HelenTsvetkova/KMM-2021/Манипулятор/Манипулятор_Обзор+ТЗ+расчеты двигателей.docx

Выбор конструкции манипулятора

# 1. Анализ технического задания

Целью работы является разработка манипулятора, являющегося составной частью подвижного робота, участвующего в соревновании «Кубок РТК».

Исходя из анализа регламента турнира [ССЫЛКА НА ИНТЕРНЕТ-РЕСУРС], разрабатываемый манипулятор должен соответствовать следующим требованиям:
Масса манипулятора: не более 2 кг;

Нагрузка на выходном звене: до 0,5 кг;

Крутящий момент на выходном звене: до 1 Н∙м ;

Для обеспечения конкурентоспособности разрабатываемого робота, произведен анализ возможных испытаний, задействующих манипулятор и проводимых на «Кубке РТК». Суть данных испытаний и их стоимость в баллах представлены в таблице 1.

Таблица 1 – Испытания, проводимые на Кубке РТК

Испытание | Описание | Возможные баллы
Траншея | Фанерная площадка с двумя продолговатыми прямоугольными траншеями глубиной 40 мм. Длина траншеи – 670 мм, ширина – 140 мм. Одна траншея заполнена теннисными мячами (65 мм в диаметре), вторая пустая. Задачи: - преодолеть испытание; - Доставить мяч из одной траншеи в другую. За каждый доставленный мяч начисляются баллы. | 4 + (5+3)x, где x – количество захваченных и доставленных в другую траншею мячей.

Продолжение таблицы 1

Дверь | Дверь открывающаяся в обе стороны на 90^(°) с ручкой типа штанга. Габаритные размеры двери – 480x480x8 мм. Для открытия необходимо усилие 200 г (2 Ньютона). Высота ручки над полом – 220 мм, толщина 8 мм, длина 110 мм. Задача: - Открыть дверь на себя или от себя (во втором случае необходимо привести дверь в положение "открыто" под углом 90^(°) . | 6 баллов – если открыть дверь на себя, 1 балл – если от себя.
Вентили | На стене закреплена конструкция из сантехнических труб с вентилями различного типа и размера: рычаг (размер ручки – 90x15x5 мм, ход - 90^(°) ), бабочка средняя (размер ручки – 50x15x5 мм, ход 70^(°) ), бабочка малая (размер ручки – 25х7х15 мм, ход - 90^(°) ), задвижка клиновая (размер ручки – 50х15х5 мм, ход – 3,5 полных оборота). Момент, необходимый для поворота вентилей: - бабочка маленькая и клиновая задвижка – 0,3 Нм; - рычаг – 0,5 Нм; - Бабочка средняя – 1 Нм. Задачи: - Повернуть вентиль до перекрытия риски, обозначенной маркером на вентиле. | За поворот рычага 10 баллов. За поворот клиновых задвижек – 11 баллов. За поворот малых и средних бабочек – по 12 баллов за каждую.

Продолжение таблицы 1

Кнопка | Обыкновенный бытовой выключатель для лампочки. При нажатии загорается светодиодная лента на участке "Туман". Кнопка расположена на высоте не более 70 мм от пола. Задача: - Нажать кнопку любым способом. | 3 балла

Маяки

Маяк представляет собой алюминиевый цилиндр диаметром 67 мм. Маяки имеют один из следующих цветов: красный, синий, зеленый, желтый, фиолетовый.

На линии для автономного прохождения также могут располагаться белые маяки. Робот при этом должен находиться на расстоянии более 30 см от маяка.

Башенка – постамент, представляющий собой миниатюрную копию специального испытания "Башня", с габаритными размерами 160 мм высотой и диаметром 90 мм. На него устанавливают стандартный маяк.

Задачи:

-Цветные маяки. Захват и подъем маяка, доставка любым способом его в соответствующую по цвету зону.

- Белые маяки. Захват и подъем маяка на перекрестке черных линий и доставка на другой перекресток.

- Башенка. Баллы за захват плюсуются с баллами за захват с башенки.

В зависимости от сложности испытания можно получить от 0 до 83 баллов.

Продолжение таблицы 1

Обломки | Предметы разного веса, размера, формы, текстуры. Материалы: пластик, дерево, резина, поролон. Габариты обломков колеблются в пределах от 160 до 35 мм, вес до 100 г. Задача: - Собрать предметы в корзинку (высота корзинки- 90 мм). За захват и доставку каждого предмета баллы начисляют отдельно. | Захват обломка – 4 балла, доставка – 3 балла.

Трубы

Конструкция из пластиковых труб, подвешенная на стене ячейки. Каждая труба оканчивается шестиугольной крышкой со стороной 40 мм. Длина подвижных трубок 60 мм.

Задача:

- Извлечь. В трубу вложена трубка меньшего диаметра. Робот должен захватить и полностью извлечь трубку

- Повернуть. В трубу вложена трубка меньшего диаметра. Робот должен повернуть трубку вокруг своей оси, на 180/360 градусов, не вытаскивая из основной трубы. Одну трубку можно повернуть не более, чем на один полный оборот ( 360^(°) ).

- Исследовать. Внутри трубы, на донышке написана буква/цифра. Оператор и судья должны четко разглядеть символ на дне трубы.

5 баллов за извлечение меньшей трубки из большей. 5 баллов за исследование того, что находится внутри большой трубки. 9 и 12 баллов можно получить за поворот меньшей трубки в большей на 180^(°) и 360^(°) соответственно.

Продолжение таблицы 1

Мишень | Концентрические круги, распечатанные на бумаге, и закрепленные на стенке полигона. Три мишени закреплены на разном уровне. Мишень состоит из 5 кругов разного диаметра. Диаметр мишени – около 15 см.

# 2. Обзор существующих решений

С целью определения наилучшей конструкции манипулятора для получения максимального количества баллов за испытания, решено провести обзор существующих конструкций манипуляторов и выбор самой подходящей из них. Объектами исследования стали манипуляторы роботов, участвовавшие в Кубке РТК в 2018–2021 годах.

Трудность данной задачи заключается в невозможности сопоставления фотографий роботов, принимающих участие в соревнованиях, с полученными ими результатами за каждое испытание. Вследствие этого принято решение проанализировать все имеющиеся фотографии на сайте Кубка РТК, разделив роботов на группы по количеству степеней подвижности манипулятора. Далее для каждой группы определены лучшие представители, и посчитано, какое количество баллов способен набрать каждый из них.

В результате проведенного анализа выявлено, что манипуляторы роботов-участников Кубка РТК делятся на следующие группы:

- с одной позиционирующей степенью подвижности (ПСП);
- с одной позиционирующей и одной ориентирующей степенью подвижности (ОСП);
- с двумя ПСП;
- с двумя ПСП и одной ОСП;
- с тремя ПСП;
- с тремя ПСП и одной ОСП;
- с тремя ПСП и двумя ОСП.

Лучшие представители данных групп представлены на рисунках 1–7.

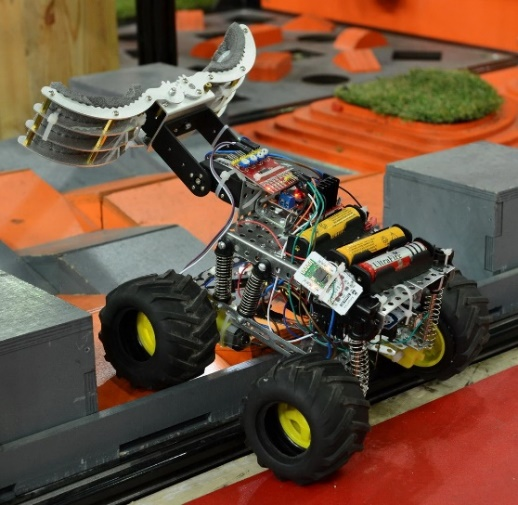
[picture p1: figure]

Рисунок 1 – Робот с манипулятором с одной ПСП

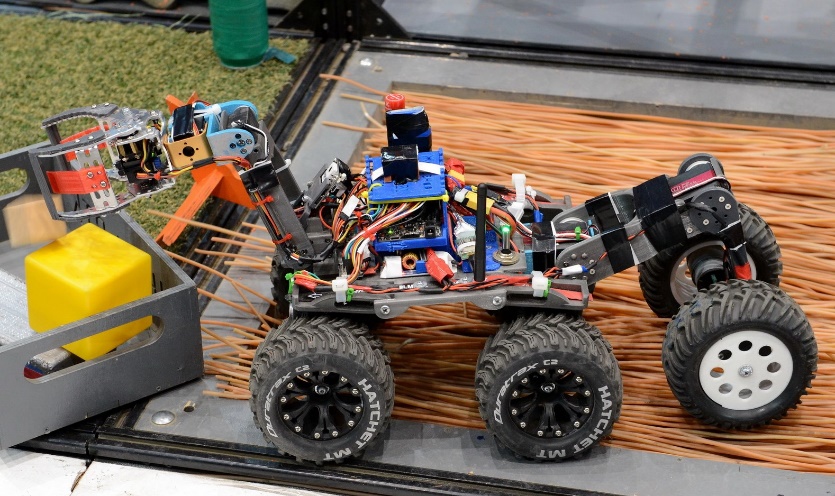
[picture p2: figure]

Рисунок 2 – Робот с манипулятором с двумя ПСП

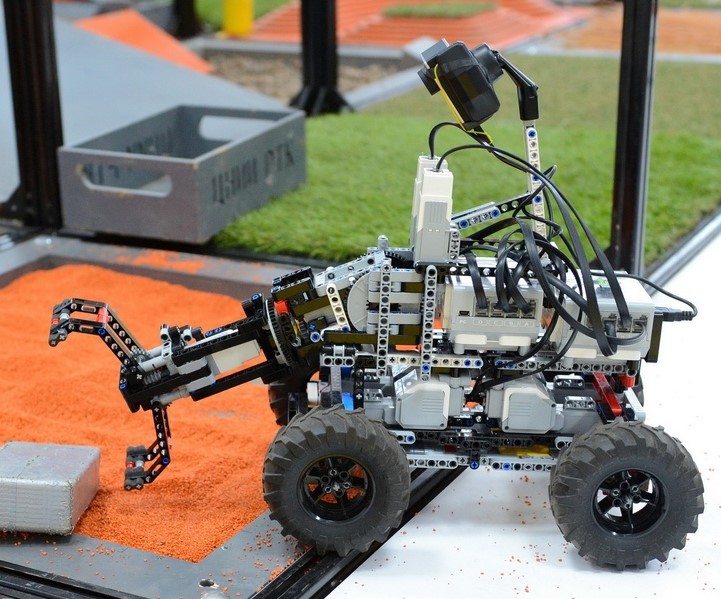
[picture p3: figure]

Рисунок 3 – Робот с манипулятором с одной ПСП и одной ОСП

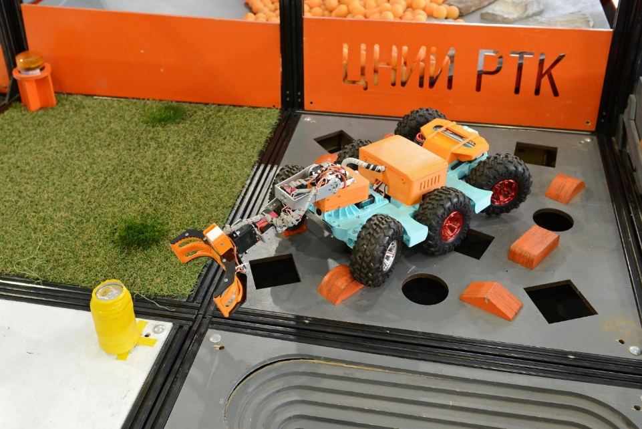
[picture p4: figure]

Рисунок 4 – Робот с манипулятором с тремя ПСП

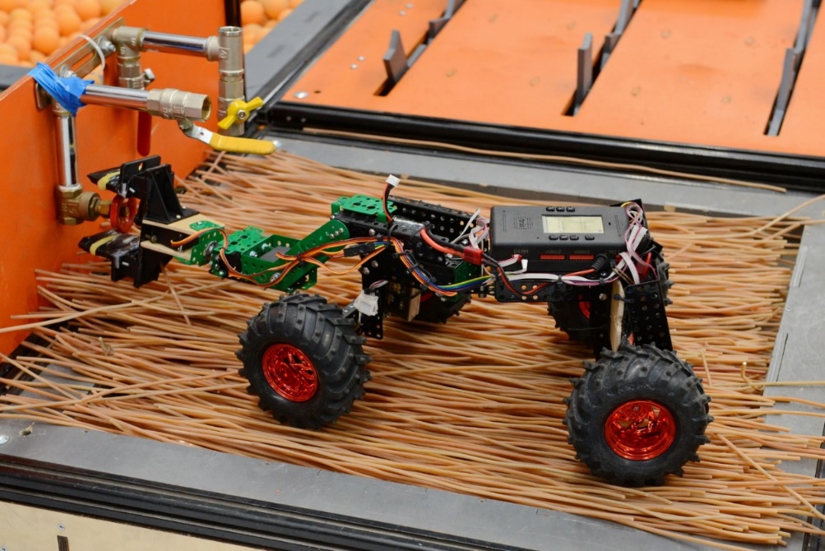
[picture p5: figure]

Рисунок 5 – Робот с манипулятором с двумя ПСП и одной ОСП

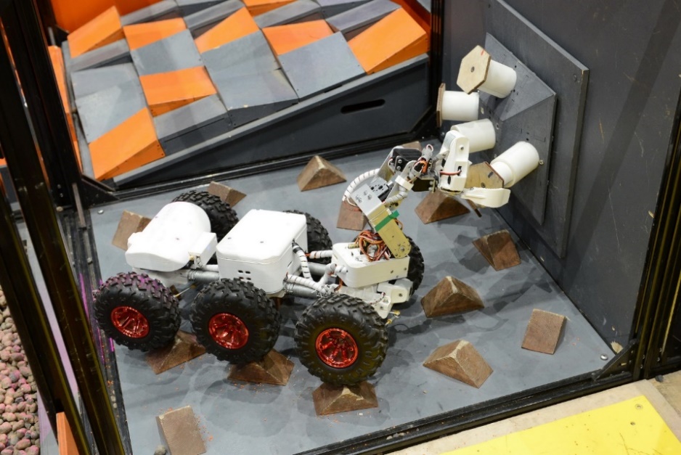
[picture p6: figure]

Рисунок 6 – Робот с манипулятором с четырьмя ПСП

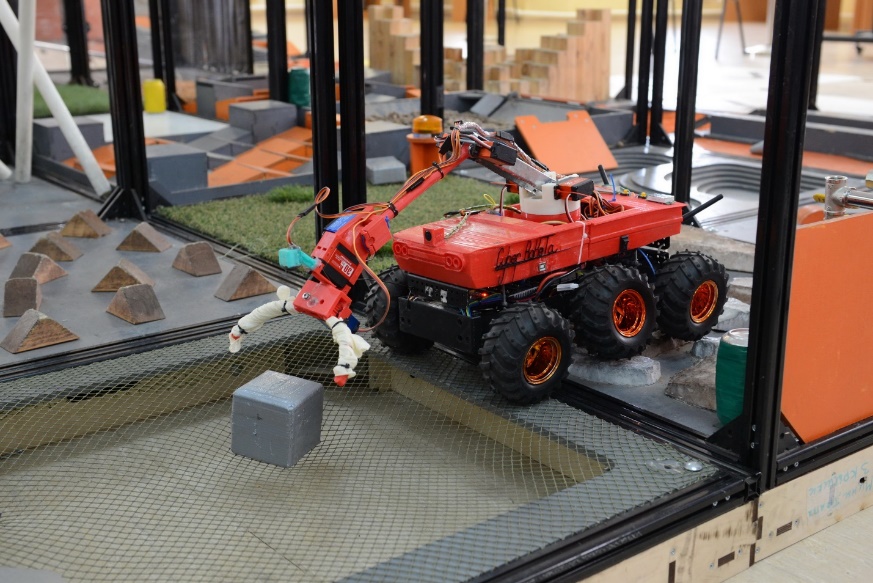
[picture p7: figure]

Рисунок 7 – Робот с манипулятором с тремя ПСП и одной ОСП

Произведен анализ успешности прохождений испытаний каждым из роботов (рис. 1–7). Результаты анализа представлены в таблице 2.
Таблица 2 – Оценочная таблица успешности прохождений испытаний роботами различных категорий

Испытание | 1 ПСП | 2 ПСП | 1 ПСП, 1 ОСП | 3 ПСП | 2 ПСП, 1 ОСП | 4 ПСП | 3 ПСП, 2 ОСП
Траншея | 8 | 8 | 8 | 8 | 8 | 8 | 8
Дверь | 6 | 6 | 6 | 6 | 6 | 6 | 6
Вентили | 0 | 0 | 45 | 0 | 45 | 45 | 45
Кнопка | 3 | 3 | 3 | 3 | 3 | 3 | 3
Маяки | 73 | 83 | 73 | 83 | 83 | 83 | 83
Обломки | 7 | 7 | 7 | 7 | 7 | 7 | 7
Трубы | 5 | 10 | 14 | 10 | 19 | 19 | 19
Мишень | 4 | 6 | 10 | 8 | 10 | 10 | 10
Итого: | 106 | 123 | 166 | 125 | 181 | 181 | 181

Исходя из результатов оценочной таблицы 2 можно сделать вывод, что робот, обладающим манипулятором с одной ПСП, не способен выполнить задания, связанные с вращением, а также будет задания, требующие высокой точности. Также с одной ПСП сложно достать предмет, находящийся на большой высоте.

Роботы, обладающие манипулятором с двумя или тремя ПСП, в лучшем случае, смогут справиться с теми же заданиями, что и робот, обладающий манипулятором с одной ПСП. Однако, роботы данной группы лучше справятся с заданием «Маяки», в задании «Трубы» смогут не только извлечь, но и исследовать трубу, также покажут лучшую точность в задании «Мишень», но по-прежнему не смогут выполнить задания, связанные с вращением.

Роботы, обладающие манипулятором с одной ПСП и одной ОСП в лучшем случае смогут справиться с заданиями, связанными с вращением, и добьются лучшей точности на задании «Мишень», но потеряют баллы на исследовании трубы в задании «Трубы».

Роботы, обладающие манипуляторами с двумя ПСП и одной ОСП; а также с четырьмя и пятью степенями подвижности, по выполненной оценке, способны набрать максимум баллов при грамотном управлении оператором.

Поэтому в качестве наилучшего выбран манипулятор, обладающий наиболее простой конструкцией – трехстепенной манипулятор, обладающий двумя ПСП и одной ОСП.

Расчет и выбор двигателя

# 1. Проектировочный расчет

Для осуществления движения манипулятора с тремя степенями подвижности необходимо наличие трех приводов. Учитывая массогабаритные ограничения [ТА ЖЕ ССЫЛКА НА ТЗ], накладываемые на разрабатываемого робота, принято решение об использовании сервоприводов, обладающих высокой точностью позиционирования за счет наличия обратной связи по положению, высоким КПД, небольшими размерами, а также небольшого количества требуемых соединений (проводов), усложняющих конструкцию манипулятора.

Для выполнения задания «Трубы» и обеспечения видимости оператору внутри трубы, решено установить на бурт, на котором располагается соединения со схватом, USB FPV-камеру.

В качестве материала, из которого изготавливается манипулятор, выбран углепластик благодаря его легкости, а также высоким прочностным характеристикам.

Для снижения требуемой нагрузки и облегчения конструкции решено установить приводы как можно ближе к основанию манипулятора. По этой причине один из приводов закреплен на основании и служит для вращения первым звеном манипулятора, а второй при помощи вспомогательного рычага осуществляет вращение вторым звеном.

Целью проектировочного расчета является расчет требований к моменту и мощности серводвигателей за счет проведения статического расчета манипулятора в крайнем положении, при котором нагрузка будет максимальной.

Т.к. большая часть массы манипулятора сосредоточена на схвате, особенно при необходимости в переноске груза, условие максимальной нагрузки выполняется при максимальном расстоянии от двигателя до выходного звена. Таким образом, манипулятор в крайнем положении, при котором проведен статический расчет, представлено на рисунке 8.

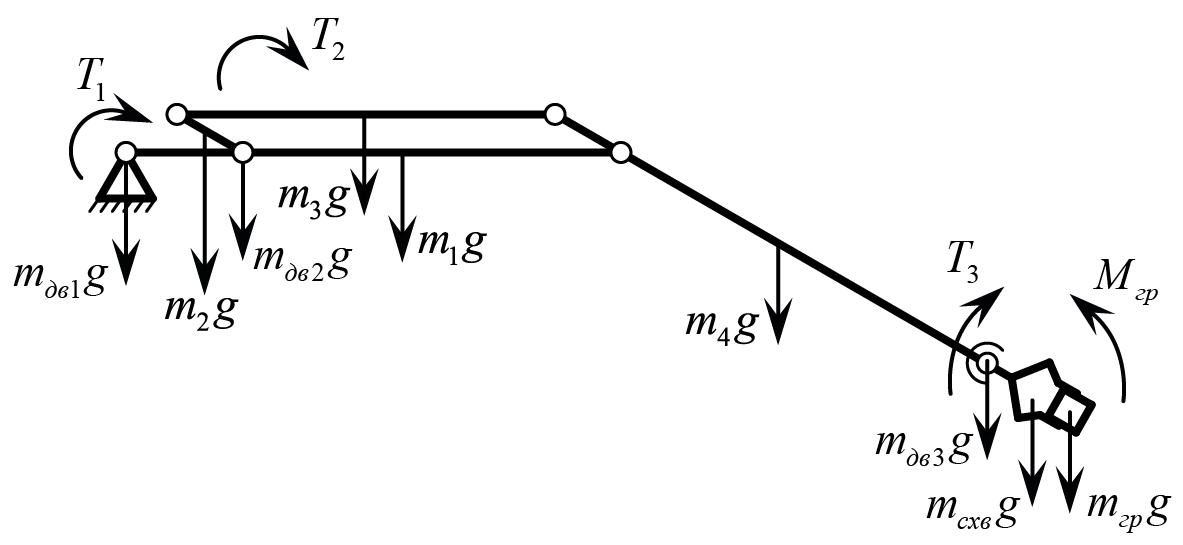
[picture p8: figure]

Рисунок 8 – Кинематическая схема манипулятора в крайнем положении

где g- ускорение свободного падения, m_1 , m_2 , m_3 , m_4 - массы звеньев манипулятора, m_(сх) - масса схвата, m_(гр) - масса груза, f- угол наклона четвертого звена, m_(дв1) , m_(дв2) , m_(дв3) - массы двигателей, a- расстояние от шарнира между первым и четвертым звеном до второго двигателя, M_(гр) - максимальный крутящий момент необходимый для поворота оперируемым предметом.

Назначенные на основании ТЗ массогабаритные характеристики манипулятора с выбранными длинами звеньев l и массами m представлены в таблице 3.

Таблица 3 — Массогабаритные характеристики манипулятора

m_1 | 0,015 кг | l_1 | 0,130 м
m_2 | 0,001 кг | l_2 | 0,020 м
m_3 | 0,004 кг | l_3 | 0,100 м
m_4 | 0,015 кг | l_4 | 0,130 м
m_(сх) | 0,300 кг | l_(сх) | 0,050 м
m_(гр) | 0,500 кг | l_(гр) | 0,050 м
m_(дв1) | 0,100 кг | a | 0,100 м
m_(дв3) | 0,100 кг | m_(дв2) | 0,100 кг
M_(гр) | 1 Н/м | f | 30°

Таким образом, моменты, действующие на первый и второй двигатели будут следующие

T_(ст1) =(l_1)/2∙m_1 g+m_2 g∙(l_2)/2cos(f)+m_3 g∙(l_1)/2+m_4 g∙(l_1 +(l_4)/2cos(f)) +m_(сх) g∙(l_1 +l_4 cos(f)+(l_(сх))/2cos(f))+m_(гр) g∙(l_1 +l_4 cos(f)+ +l_(сх) cos(f)+(l_(гр))/2cos(f)+m_(дв2) g∙(l_1 -a)+m_(дв3) g(l_1 +l_4 cos(f)) | (1)

T_(ст2) =-m_2 g∙(l_2)/2cos(f)+m_3 g∙((l_1)/2-(l_1 -a))+m_4 g∙ (a+l_4 ∙cos⁡(f))+m_(сх) g∙(a+l_4 cos(f)+(l_(сх))/2cos(f))+m_(гр) g∙ ∙(a+l_4 cos(f)+l_(сх) cos(f)+(l_(гр))/2cos(f))+m_(дв3) g(a+l_4 cos(f)) | (2)
T_(ст3) =M_(гр) | | (3)

После подстановки в формулы 1 и 2 массогабаритных характеристик манипулятора, представленных в таблице 1, получено

T_(ст1) =2,28 Н/м

T_(ст2) =1,96 Н/м

T_(ст) =1 Н/м

Для учета динамических характеристик решено при выборе двигателей сделать запас по моменту в 10%.

T=T_(ст) ∙0,1 | (3)

Таким образом, получено

T_1 =2,51 Н/м

T_2 =2,15 Н/м T_3 =1,1 Н/м

На основании полученных моментов для первого зве характеристики которых представлены в таблице 4.

Таблица 4 — Характеристики выбранных двигателей

№ | Сервопривод | Характеристики
| | Мощность, Вт | Момент,
1 | RDS3235 | 8,73 | 3,5
2 | RDS3225 | 6,16 | 2,5
3 | MG996 | 8,06 | 1,5

# 2. Проверочный расчет

Предположим, что для разрабатываемого манипулятора справедлива средняя скорость вращения звеньев ω=15°/с , а для серводвигателей справедливо следующее соотношение

t=0,1∙T | (4)

где t- время на разгон (торможение), T- общее время работы.

Пусть φ- требуемый угол поворота звена.

Тогда

T=φ/ω | (5)
t=0,1∙T=0,1∙φ/ω | (6)

Отсюда установившаяся скорость движения двигателя

ω_h =φ/(T-t)=φ/(0,9∙φ/ω)=ω/(0,9)=16,7°/с =0,291 рад/с | (7)

В таком случае требуемые мощности двигателей

P=T∙ω_h | (8)

Отсюда

P_1 =0,73 Вт

P_2 =0,63 Вт

P_3 =0,29 Вт

Выбранные ранее двигатели удовлетворяют найденным мощностям.
