HelenTsvetkova/KMM-2021/Платформа/ПЗ/3_глава_ПЗ.docx

1. Расчёт параметров двигателя
  1.1. Определение требований к характеристикам привода

Необходимо определить следующие требования к характеристикам привода:

- частота вращения выходного вала, об/мин;
- крутящий момент на выходном валу, Н∙м.

Перечислим заданные параметры и требования к роботу:

- Масса робота: M = 3 кг
- Минимальное количество колёс в зацеплении с дорогой: n = 3 шт
- Масса на одно колесо: m = M / n = 1 кг
- Диаметр колеса: d = 0.085 м
- Требуемая скорость: V = 0.5 м/с
- Требуемое ускорение: a = 1 м/с^2
- Максимальный наклон поверхности: θ = 30 град = 0.524 рад
- Ускорение свободного падения: g = 9.8 м/с^2
- Коэффициент сопротивления качению выбираем из табличных данных:
- Таблица 1 – значения коэффициента сопротивления качению

Выбираем наихудший вариант – сухой песок, т.к. он есть на одном их этапов кубка РТК. f = 0.3

- Коэффициент сцепления шин с дорогой выбираем из табличных данных:
- Таблица 2 – значения коэффициента сцепления шин с дорогой

Выбираем наихудший вариант – самое высокое сцепление с дорогой. φ = 0.8

  1.2. Рассчёт параметров двигателей при движении по наклонной плоскости

Составим расчётную схему сил, действующих на колесо:

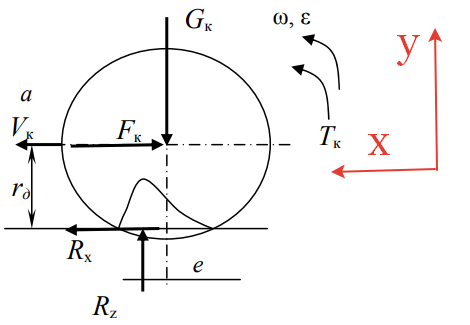
[picture p9: figure]

Рисунок 1 – расчётная схема сил, действующих на колесо

Здесь:

Gk – вес на одно колесо, Н. Gk = m*g

Tz – момент, приложенный к колесу

Rz – вертикальная реакция в контактной площадке, Н

Rx – продольная реакция, Н

Fк – продольная толкающая сила, Н

е – снос вертикальной реакции в движении

rд – радиус колеса

a – ускорение при пуске

Рассмотрим силы и момент действующие на колесо:

x:Rx-G*sin(θ)=ma

y:Rz-G*cos(θ)=0

M: -Tz+Rx*rд+Rz*e=0

Тогда выразим момент, приложенный к колесу:

Rx=m*a+G*sin(θ)=m*a+mg**sin(θ)

Rz=G*cos(θ)=m*g*cos(θ)

Tz=Rx*rд+Rz*e=Rx*rд+Rz*f*rд

Rx=Rx*φ

Tz=(φ(a+g*sin(θ))+g*cos(θ)*f)*m*rд

Подставим числа для вычисления значения пускового момента:

Tz=(0.8*(1+9.8*sin(30°))+9.8*cos(30°)*0.3)*1*0.085=0.309 Н*м=309 мН*м

Номинальный момент при a = 0 м/сек^2:

Tz=(0.8*(0+9.8*sin(30°))+9.8*cos(30°)*0.3)*1*0.085=0.275 Н*м=275 мН*м

Найдём угловую скорость вращения колес:

w=V/(rд)=0.5/0.085=11.7651/(сек)

Найдём частоту вращения двигателя:

nвращ=w/(2*π)=11.765/(2*3.14)=1.872(об)/(сек)=112.345(об)/(мин)

Найдём мощность двигателя:

P=Tz*w=0.309*11.765=3.633 Вт

  1.3. Расчёт параметров двигателей при движении по лестнице

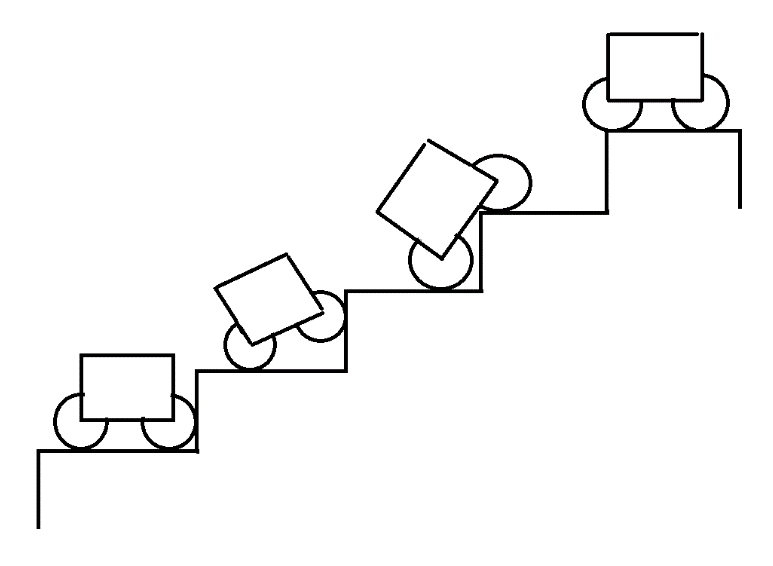
[picture p10: figure]

Рисунок 2 – порядок движений робота при подъёме по лестнице

Составим расчётную схему робота:

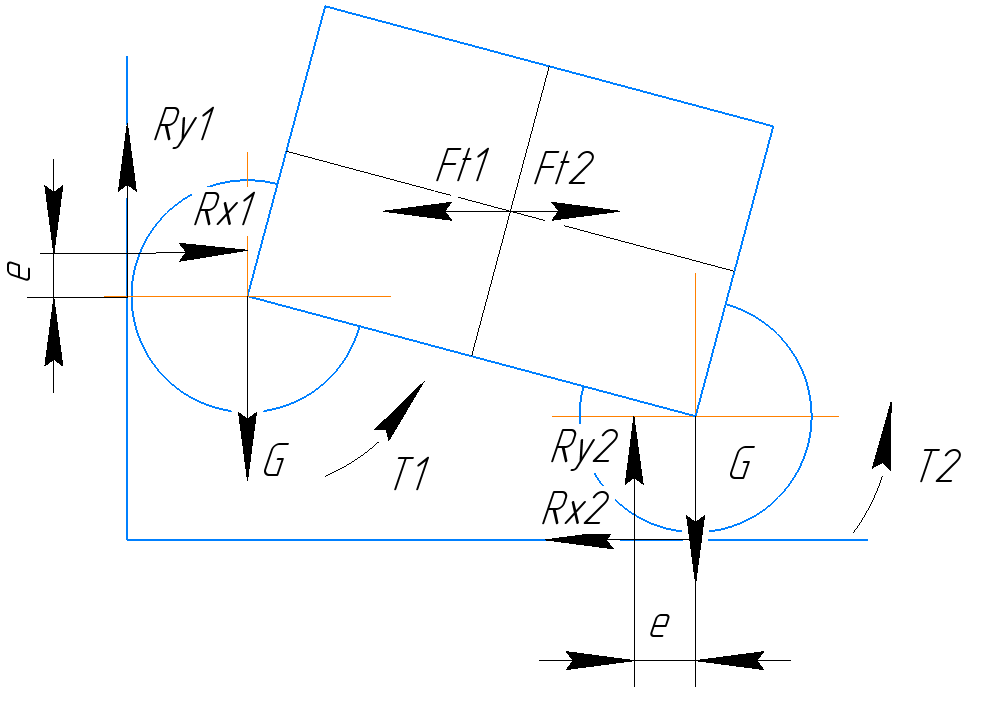
[picture p11: figure]

Рисунок 3 – расчётная схема сил, действующих на робота

Ft1=Ft2=Ft

T1=T2=T

Введём некоторые обозначения для размеров рычагов моментов сил:

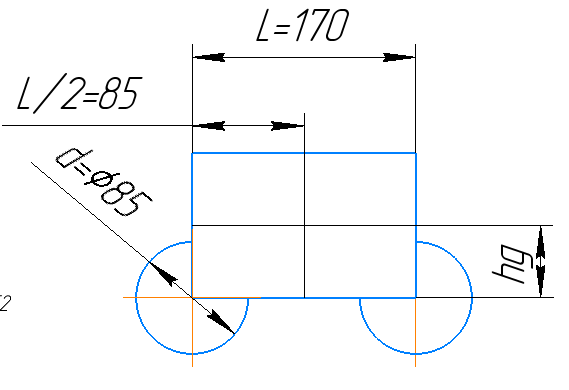
[picture p12: figure]

Рисунок 4 – габаритные размеры робота

Где hg – высота центра тяжести робота над осью колёс

L – длина продольной базы колёс

d – диаметр колёс

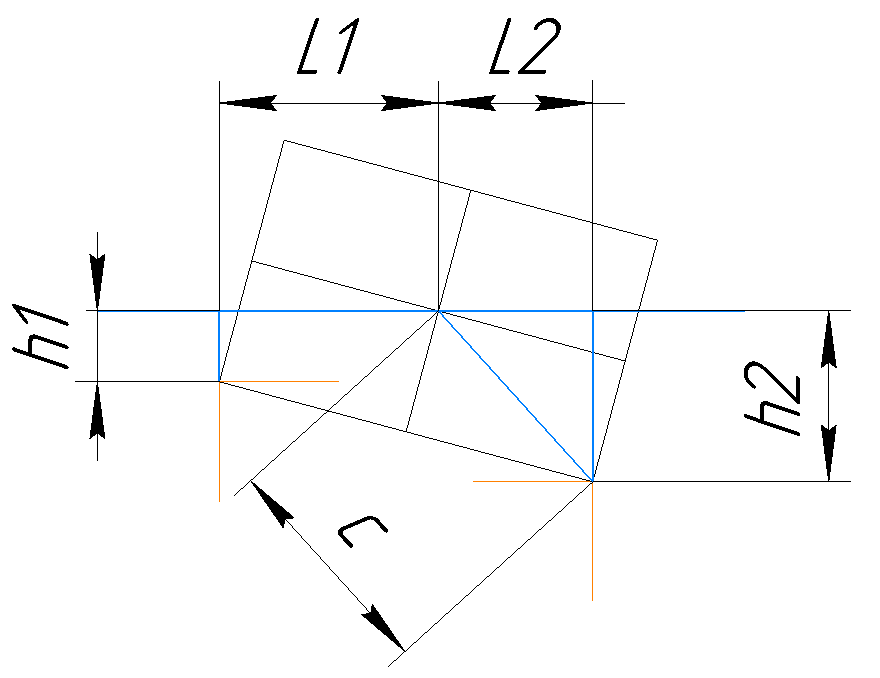
[picture p13: figure]

Рисунок 5 – условные обозначения рычагов сил, действующих на робота

Где L1, L2 – рычаги сил по оси ординат

h1, h2 – рычаги сил по оси абсцисс

с – гипотенуза прямоугольного треугольника с углом при центре тяжести

c=√(hg^2 +(L/2)^2)

Рассмотрим силы и моменты, действующие на каждое из колёс. 1ое ведущее колесо:

x:Rx1-Ft=0;Rx1=Ft

y:Ry1-G=0;Ry1=G

M01: -Rx1*e-Ry1*r+Ft*h1+T=0;

T=Rx1*e+Ry1*r-Ft*h1=-Ft*(h1-e)+G*r

Ft=(G*r-T)/(h1-e)

2ое колесо:

x:-Rx2+Ft=0;Rx2=Ft

y:Ry2-G=0;Ry2=G

M02: -Rx2*r-Ry2*e-Ft*h2+T=0;

T= Rx2*r+Ry2*e+Ft*h2=G*e+Ft*(r+h2)

Ft=(T-G*e)/(r+h2)

Из условия равенства сил Ft:

(G*r-T)/(h1-e)=(T-G*e)/(r+h2)

G*(r^2 +r*h2-e^2 +e*h1)=T*(h1-e+r+h2)

T=G*(r^2 +r*h2-e^2 +e*h1)/(h1-e+r+h2)

Для вычисления значения момента двигателя необходимо найти значение h1 и h2 в зависимости от положения робота и его центра тяжести. Введём следующие обозначения:

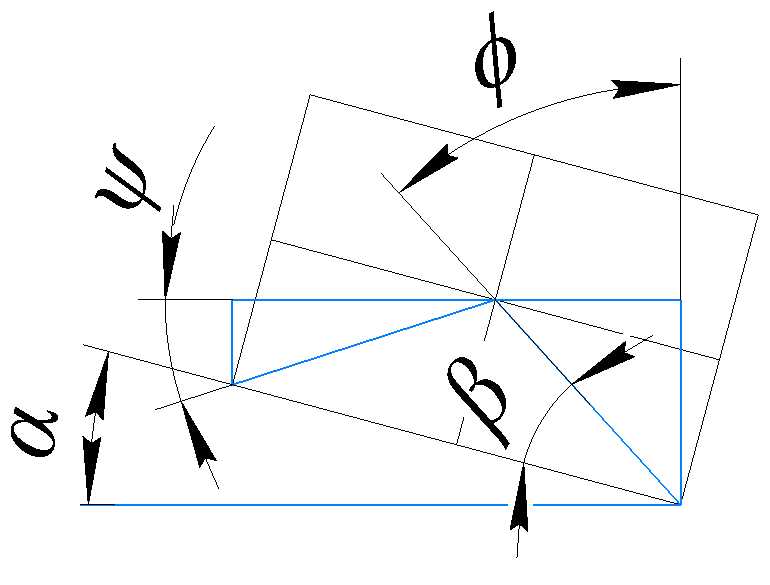
[picture p14: figure]

Рисунок 6 – условные обозначения углов

α – угол наклона робота над поверхностью пола

β – угол наклона отрезка с (гипотенуза), обозначенного выше на рисунке 5

ψ, ϕ – углы, образованные в следствии изменяющегося положения и длинны рычагов сил, действующих на робот

Значения длинн рычагов:

ψ=90-α-β=ϕ

h1=c*sin(ψ)

h2=c*cos(ψ)

Вычислим α максимальное - максимальный угол наклона робота над поверхностью пола, а так же угол β:

hл=150, мм-высота лестницы

α=acos((hл)/L)=acos(150/170)=28.072°

β=atan(L/(hg*2))=170/(90*2)=43.363°

Значения h1, h2 при угле α = max, β:

c=√(hg^2 +(L/2)^2)=√(90^2 +(170/2)^2)=123.794 мм

ψ=90-α-β=90-28.072-43.363=18.565°

h1=c*sin(ψ)=123.794*sin(18.565)=39.412

h2=c*cos(ψ)=123.794*cos(18.565)=117.353

Значение требуемого момента при максимальном угле наклона α:

G=m*g=1*9.8=9.8 Н*м

e=f*r=f*d/2=0.3*42.5=12.75 мм

T=G*(r^2 +r*h2-e^2 +e*h1)/(h1-e+r+h2)= =9.8*(42.5^2 +42.5*117.353-12.75^2 +12.75*39.412)/(39.412-12.75+42.5+117.353)=0.343 Н*м=343 мН*м

Подбираем двигатель по моменту, мощности, частоте вращения: двигатель MAXON EC-i 60 Ø60 мм, бесколлекторный, 150 W, с датчиками Холла 625858. Таблица его основных характеристик приведена ниже.

Таблица 3 – характеристики выбранного двигателя

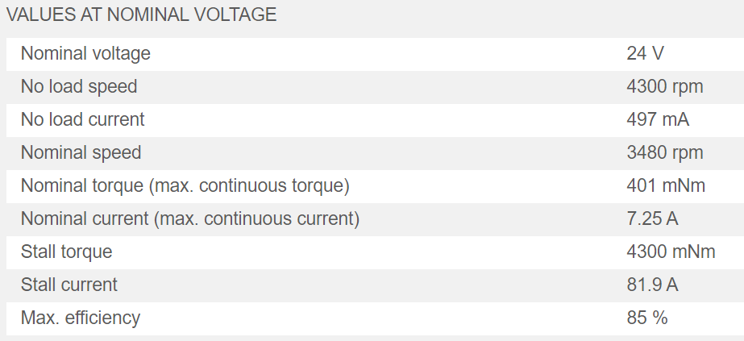
[picture p15: figure]

https://www.maxongroup.com/maxon/view/category/motor?etcc_cu=onsite
