HelenTsvetkova/KMM-2021/Платформа/solid/rpi camera/OVA5647.SLDASM

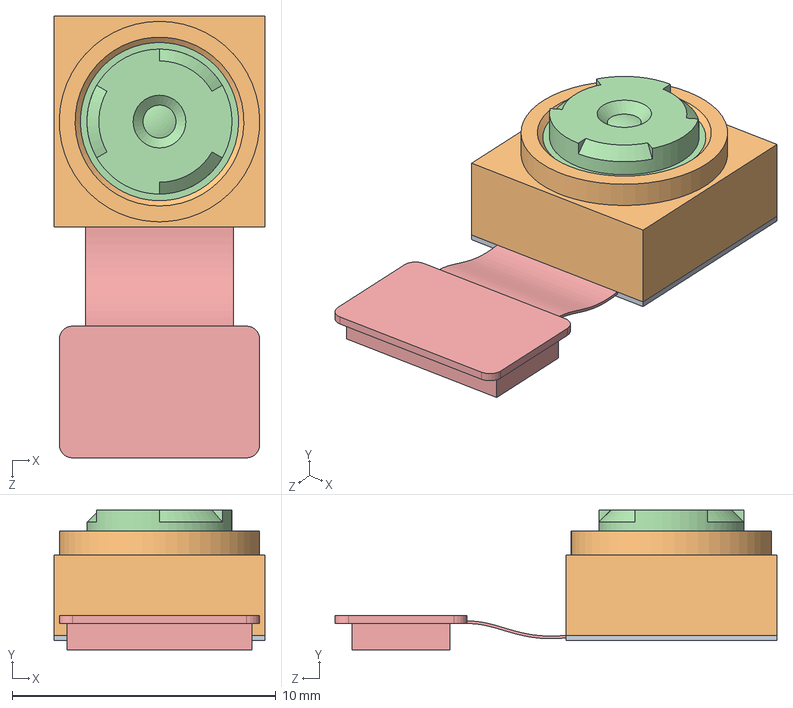
[picture p23: CAD file, 2022-03-22]
Платформа/solid/rpi camera/OVA5647.SLDASM
8.00 x 5.30 x 16.8 mm
OVA5647
OVA5647_Housing
OVA5647_IR-Glas
OVA5647_Lens
OVA5647_Pigtail
