HelenTsvetkova/KMM-2021/Схват/Assembly1.SLDASM

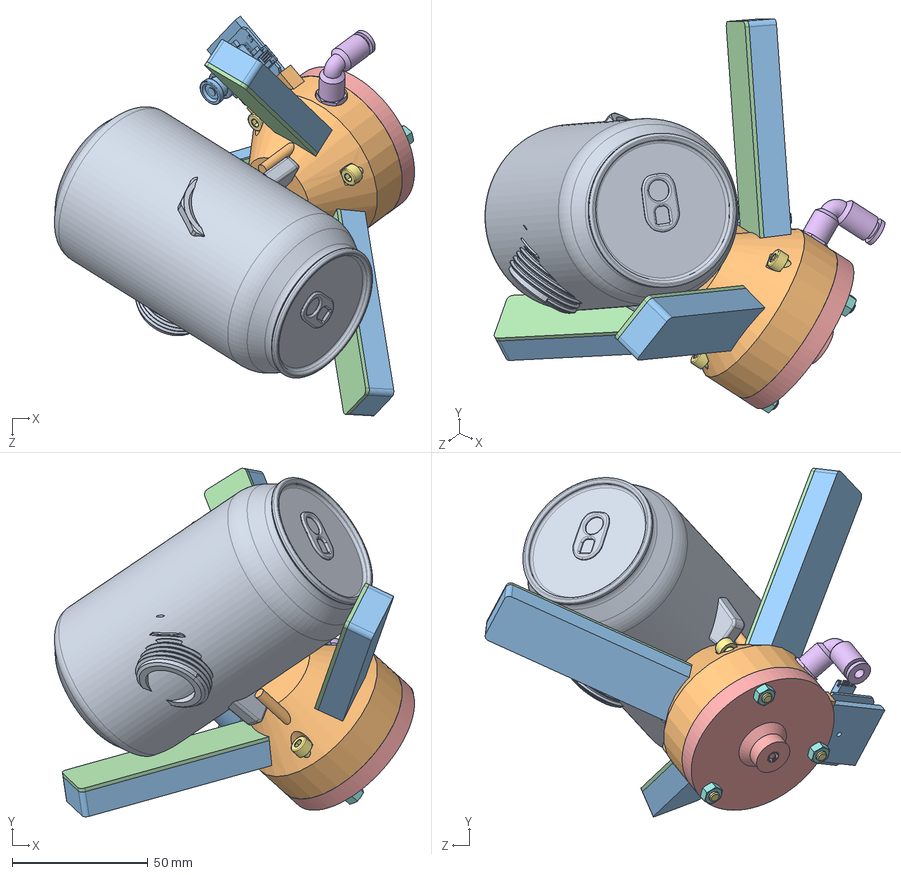
[picture p25: CAD file, 2022-05-03]
Схват/Assembly1.SLDASM
132.4 x 128.3 x 147.1 mm
Lowe
Shupal'ze22 x 3
Tkan' x 3
Upper
Ø4 x M5 COTOVELO 90° MACHO GIRAT. (C02470405)
DIN_912-M4x30.stp x 3
M4x3.3mm Hex Nut (FIX-M4).step x 3
Штифт x 2
Camera
