HelenTsvetkova/KMM-2021/Платформа/solid/rpi camera/RasPi_Camera.SLDASM

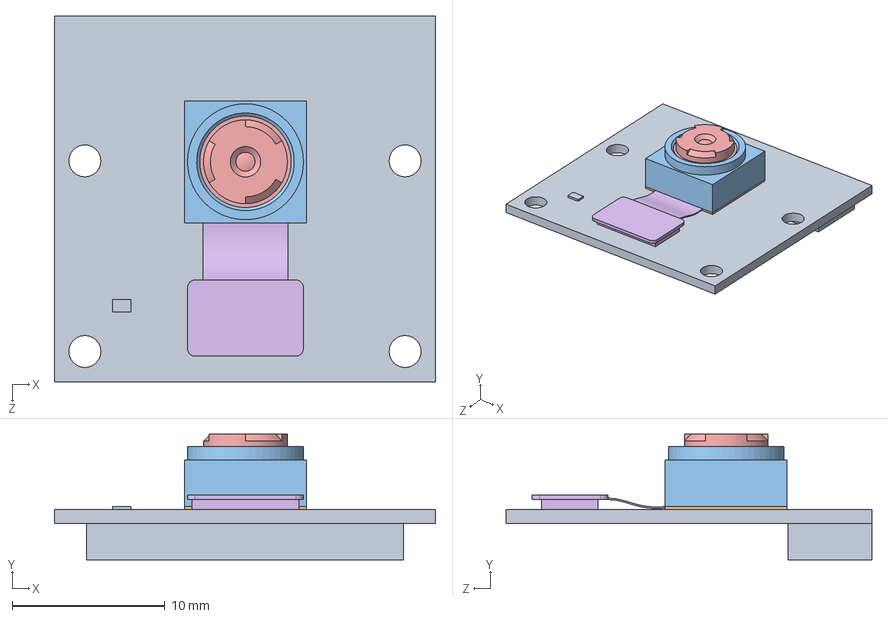
[picture p26: CAD file, 2022-03-22]
Платформа/solid/rpi camera/RasPi_Camera.SLDASM
25.0 x 8.25 x 24.0 mm
RasPi_Camera_Board
OVA5647
OVA5647_Housing
OVA5647_IR-Glas
OVA5647_Lens
OVA5647_Pigtail
