HelenTsvetkova/KMM-2021/Схват/Assembly2.SLDASM

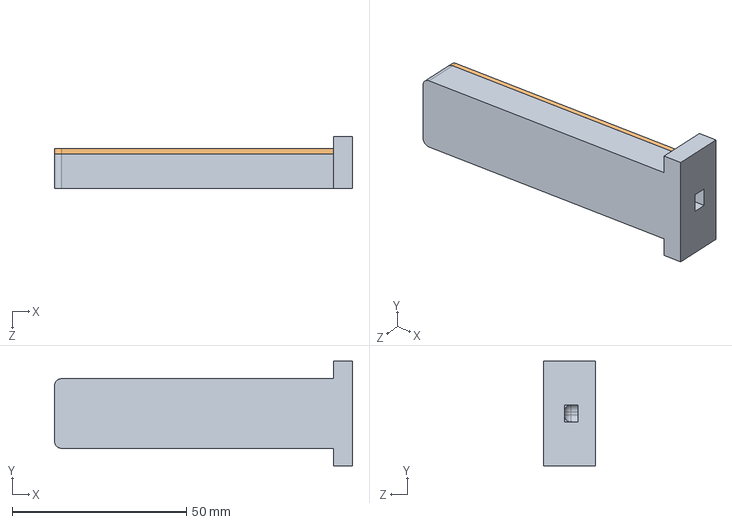
[picture p27: CAD file, 2022-04-01]
Схват/Assembly2.SLDASM
85.5 x 30.0 x 15.0 mm
Shupal'ze22
Tkan'
