HelenTsvetkova/KMM-2021/Платформа/solid/18650/BK-18650-PC6.SLDPRT

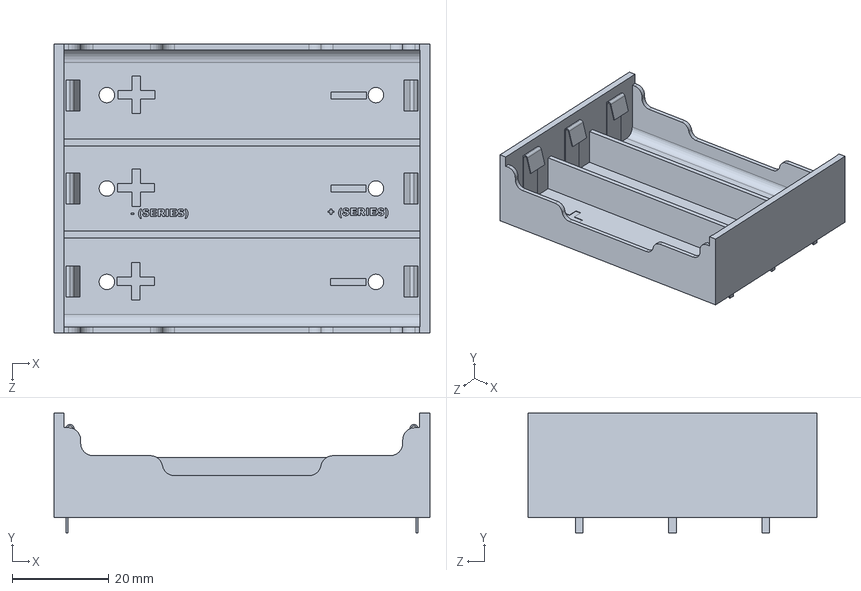
[picture p28: CAD file, 2022-03-22]
Платформа/solid/18650/BK-18650-PC6.SLDPRT
77.7 x 24.8 x 59.7 mm
