HelenTsvetkova/KMM-2021/Платформа/solid/infrared sensor/Sensor, IR, Arduino Type, Flying Fish MH-B.SLDPRT

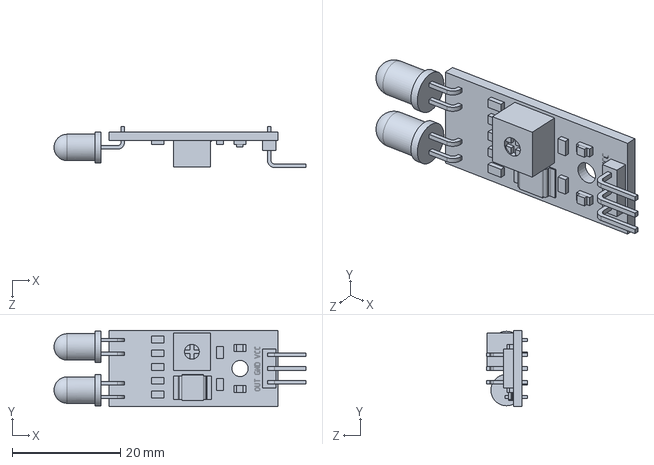
[picture p29: CAD file, 2022-03-22]
Платформа/solid/infrared sensor/Sensor, IR, Arduino Type, Flying Fish MH-B.SLDPRT
46.7 x 14.2 x 7.63 mm
