HelenTsvetkova/KMM-2021/Платформа/solid/Korpus/╨Ъ╨╛╨╗╨╡╤Б╨░.SLDPRT

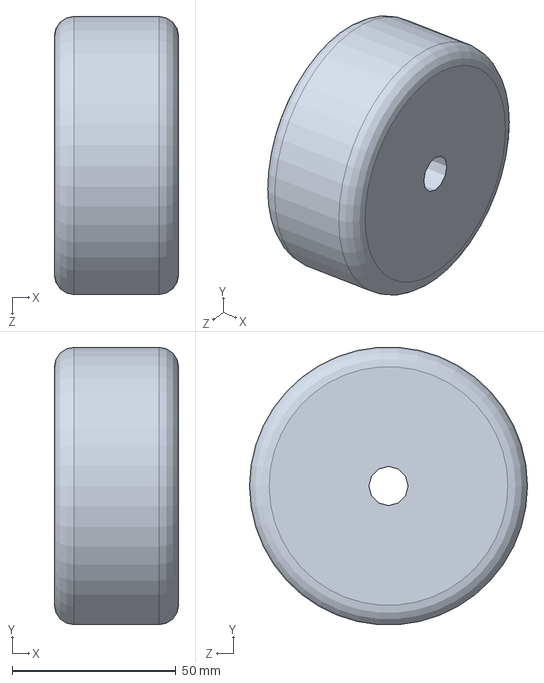
[picture p30: CAD file, 2022-03-22]
Платформа/solid/Korpus/╨Ъ╨╛╨╗╨╡╤Б╨░.SLDPRT
38.0 x 84.8 x 85.0 mm
