HelenTsvetkova/KMM-2021/Платформа/solid/raspberry pi 4 b/2.54 mm DUPONT MALE PIN HEADER, POE, 2X2, RPi4ModelB.SLDPRT

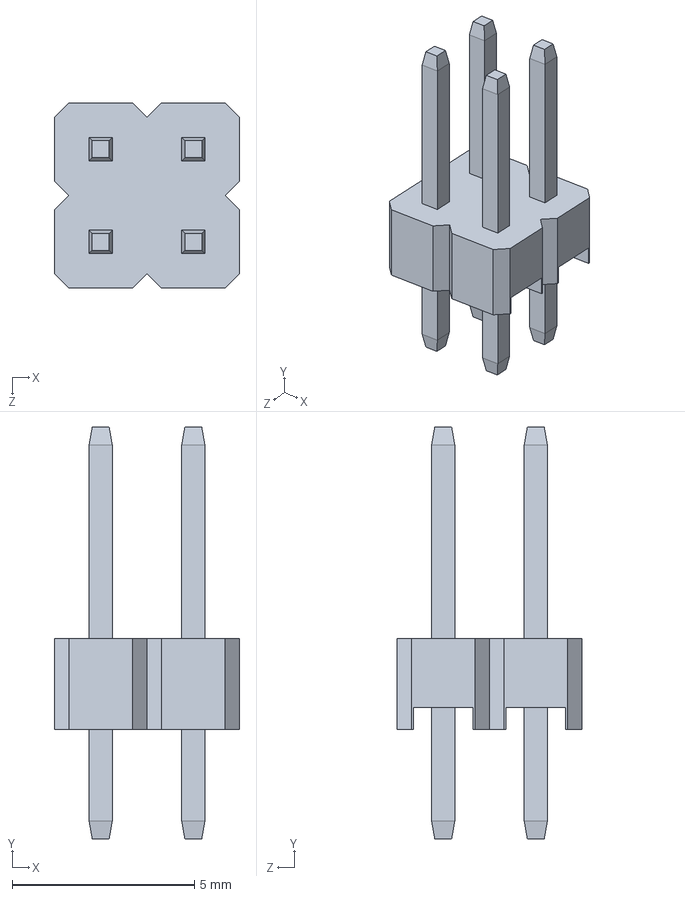
[picture p31: CAD file, 2022-03-22]
Платформа/solid/raspberry pi 4 b/2.54 mm DUPONT MALE PIN HEADER, POE, 2X2, RPi4ModelB.SLDPRT
5.08 x 11.3 x 5.08 mm
