HelenTsvetkova/KMM-2021/Платформа/solid/rpi camera/OVA5647_IR-Glas.SLDPRT

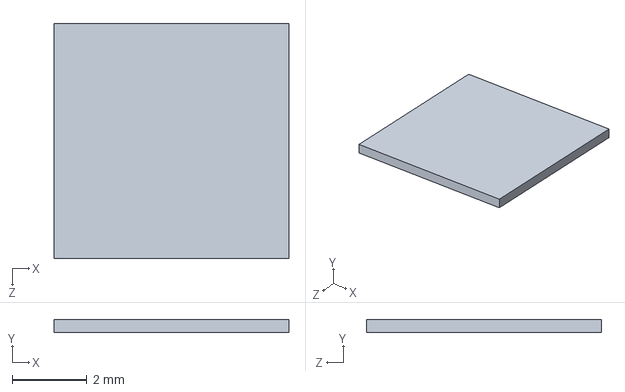
[picture p32: CAD file, 2022-03-22]
Платформа/solid/rpi camera/OVA5647_IR-Glas.SLDPRT
6.30 x 0.35 x 6.30 mm
