HelenTsvetkova/KMM-2021/Платформа/solid/servo/HS-5485HB Servo.SLDPRT

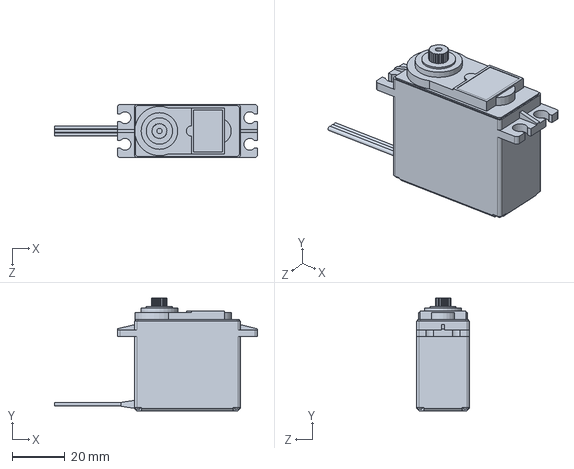
[picture p33: CAD file, 2022-03-22]
Платформа/solid/servo/HS-5485HB Servo.SLDPRT
76.8 x 42.7 x 20.0 mm
