HelenTsvetkova/KMM-2021/Схват/Camera.sldprt

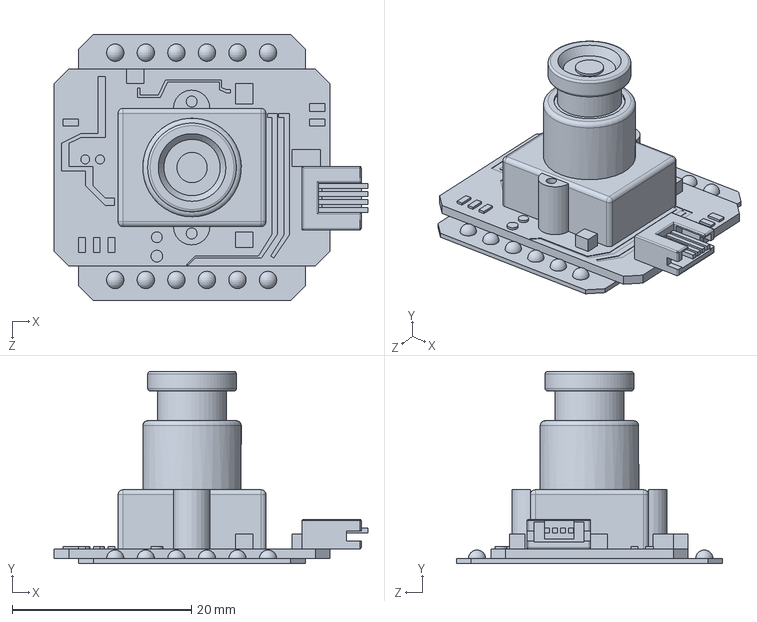
[picture p34: CAD file, 2022-05-03]
Схват/Camera.sldprt
35.0 x 21.5 x 29.7 mm
