HelenTsvetkova/KMM-2021/Платформа/solid/Korpus/╨Я╨╡╤А╨▓╨░╤П ╤З╨░╤Б╤В╤М.SLDPRT

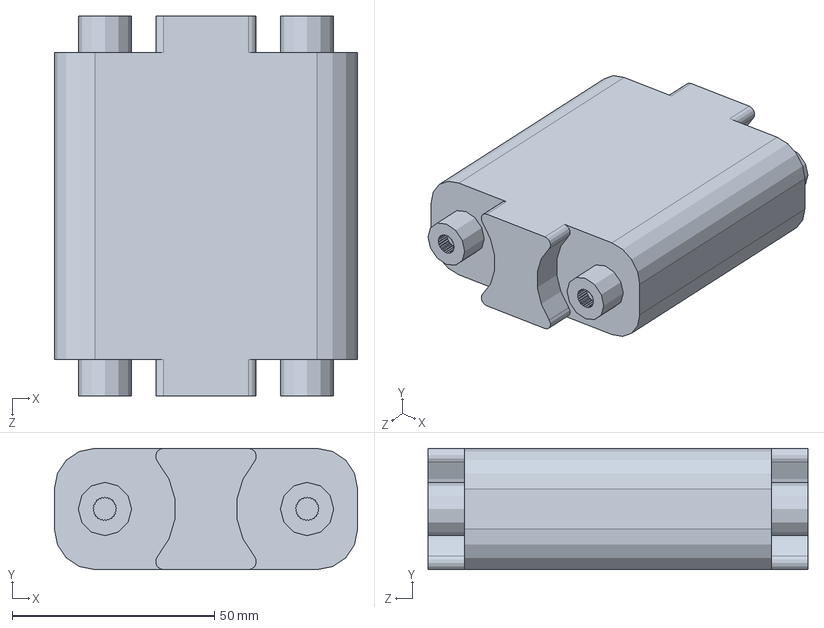
[picture p35: CAD file, 2022-03-22]
Платформа/solid/Korpus/╨Я╨╡╤А╨▓╨░╤П ╤З╨░╤Б╤В╤М.SLDPRT
75.0 x 30.0 x 94.0 mm
