HelenTsvetkova/KMM-2021/Схват/SKHVAT.STEP

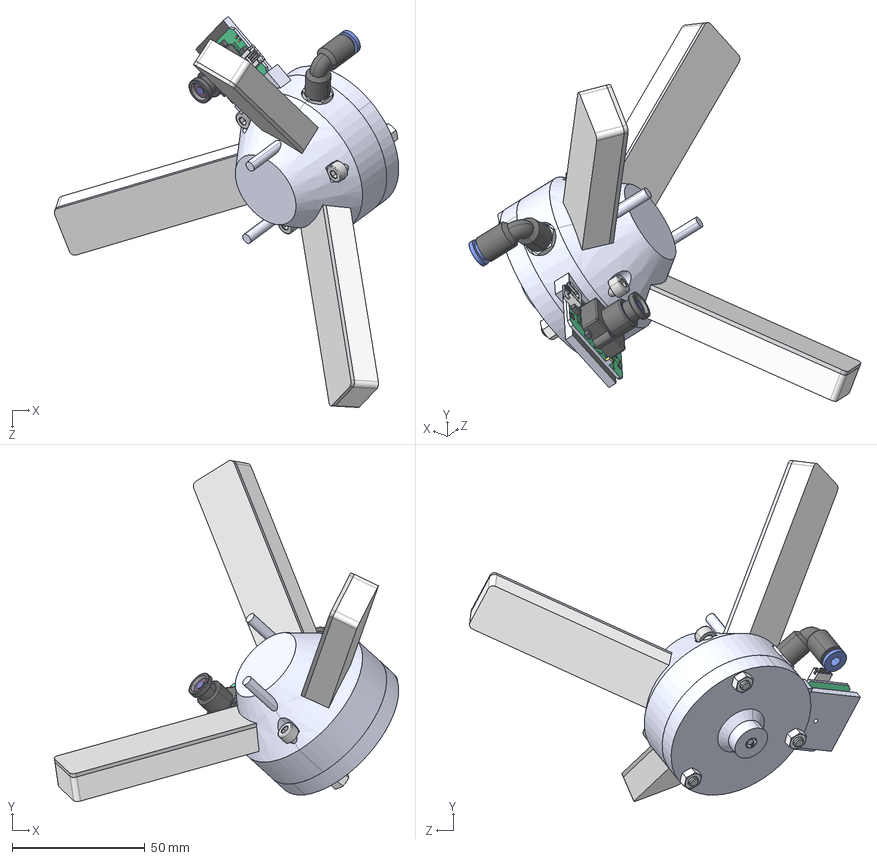
[picture p36: CAD file, 2022-05-03]
Схват/SKHVAT.STEP
129.6 x 128.3 x 147.1 mm
Lowe
Shupal''ze22 x 3
Tkan'' x 3
Upper
O4 x M5 COTOVELO 90ｰ MACHO GIRAT. (C02470405)
DIN_912-M4x30.stp x 3
M4x3.3mm Hex Nut (FIX-M4).step x 3
ﾘ x 2
Camera
