HelenTsvetkova/KMM-2021/Платформа/solid/Korpus/╨║╨╛╤А╨┐╤Г╤Б.SLDPRT

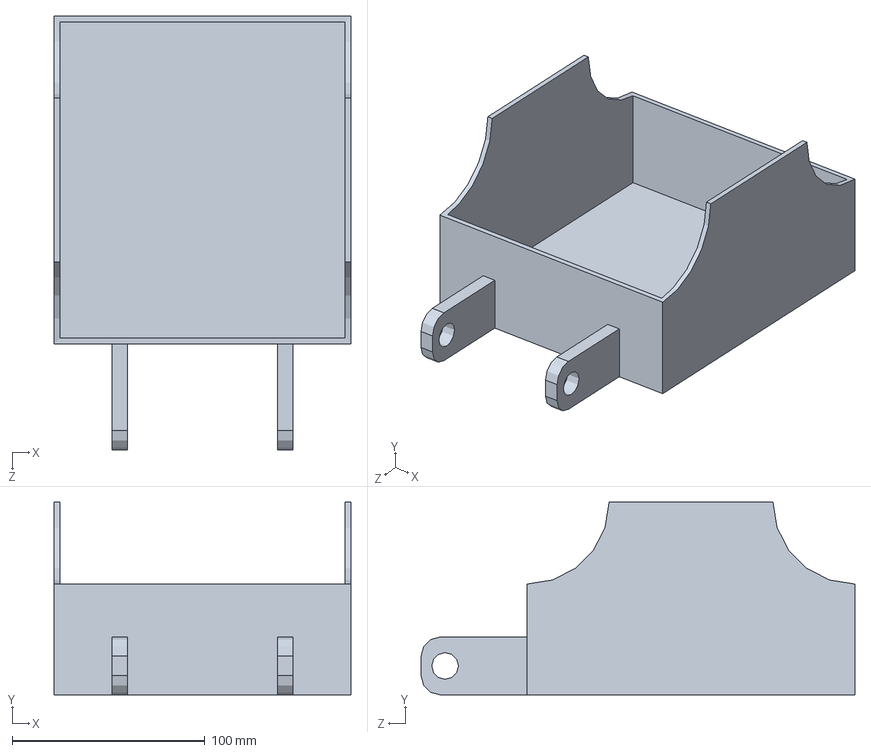
[picture p37: CAD file, 2022-03-22]
Платформа/solid/Korpus/╨║╨╛╤А╨┐╤Г╤Б.SLDPRT
154.0 x 100.0 x 225.0 mm
