HelenTsvetkova/KMM-2021/Платформа/solid/rpi camera/RasPi_Camera_Board.SLDPRT

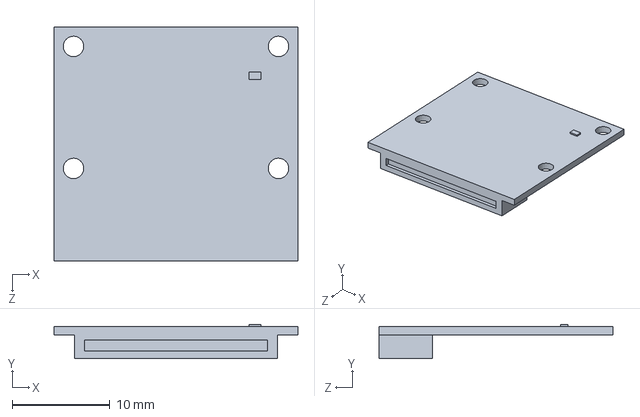
[picture p38: CAD file, 2022-03-22]
Платформа/solid/rpi camera/RasPi_Camera_Board.SLDPRT
25.0 x 3.50 x 24.0 mm
