HelenTsvetkova/KMM-2021/Схват/Lowe.SLDPRT

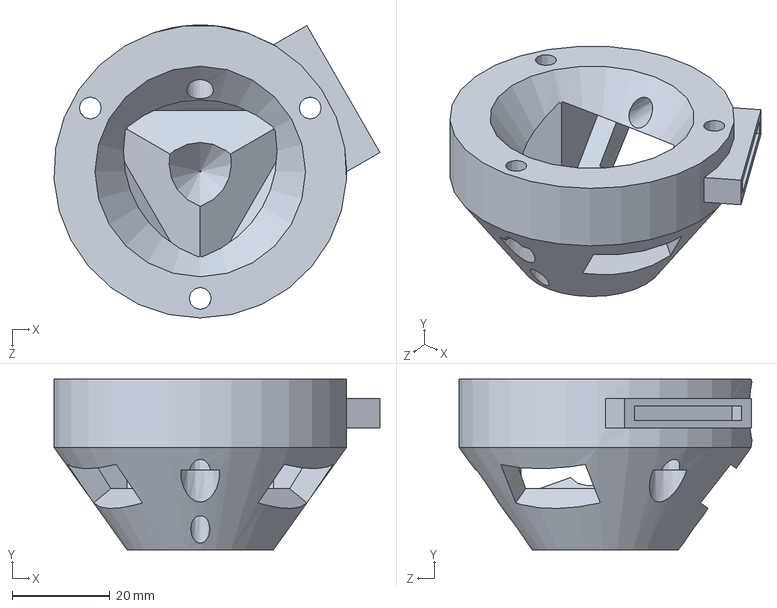
[picture p39: CAD file, 2022-05-03]
Схват/Lowe.SLDPRT
66.8 x 35.0 x 60.0 mm
