HelenTsvetkova/KMM-2021/Платформа/solid/raspberry pi 4 b/Cypress CYW43455 Wireless Module Cover, RPi4ModelB.SLDPRT

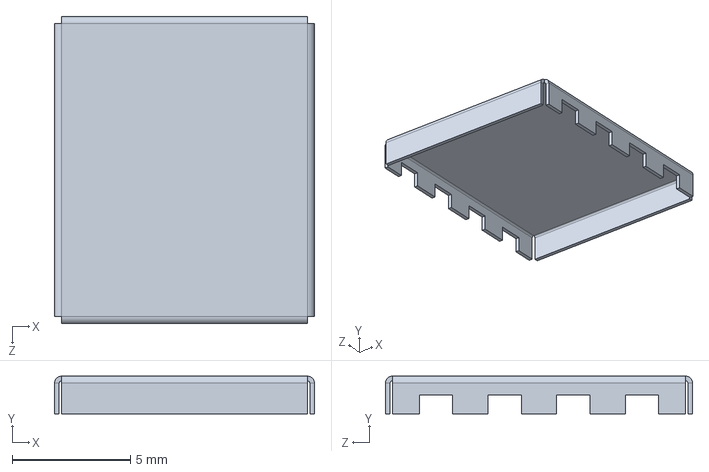
[picture p40: CAD file, 2022-03-22]
Платформа/solid/raspberry pi 4 b/Cypress CYW43455 Wireless Module Cover, RPi4ModelB.SLDPRT
11.0 x 1.60 x 13.0 mm
