HelenTsvetkova/KMM-2021/Платформа/solid/rpi camera/OVA5647_Housing.SLDPRT

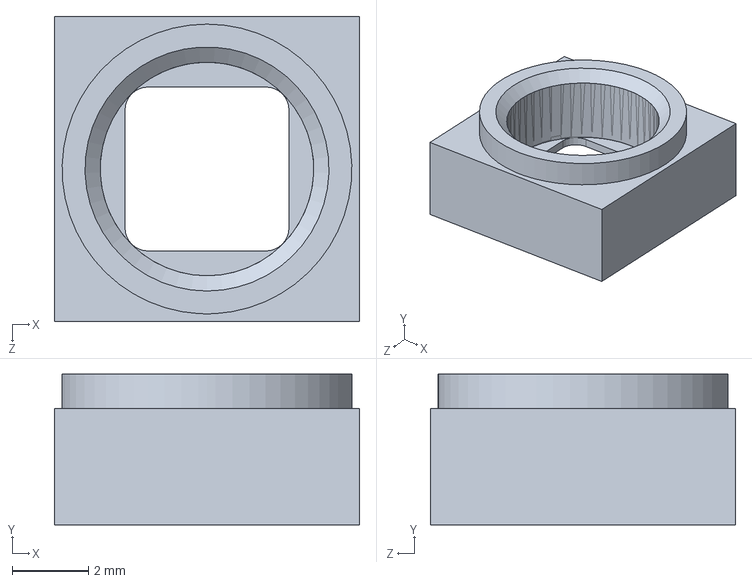
[picture p41: CAD file, 2022-03-22]
Платформа/solid/rpi camera/OVA5647_Housing.SLDPRT
8.00 x 3.95 x 8.00 mm
