HelenTsvetkova/KMM-2021/Схват/Штифт.SLDPRT

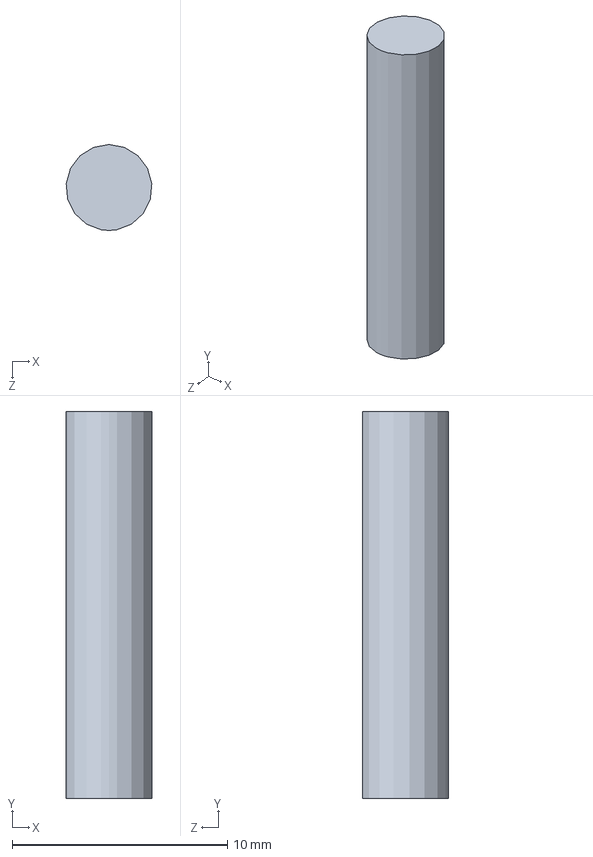
[picture p42: CAD file, 2022-05-03]
Схват/Штифт.SLDPRT
3.98 x 18.0 x 4.00 mm
