HelenTsvetkova/KMM-2021/Платформа/solid/rpi camera/OVA5647_Pigtail.SLDPRT

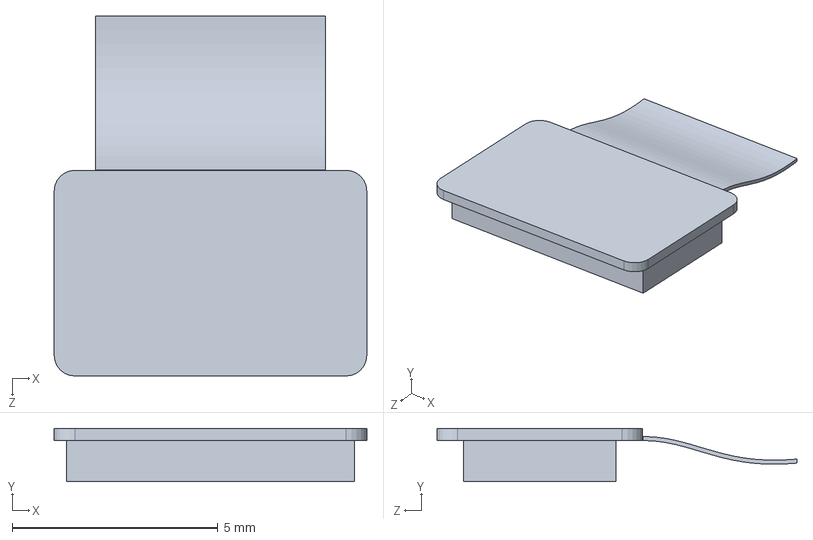
[picture p43: CAD file, 2022-03-22]
Платформа/solid/rpi camera/OVA5647_Pigtail.SLDPRT
7.60 x 1.30 x 8.75 mm
