HelenTsvetkova/KMM-2021/Платформа/solid/rpi camera/OVA5647_Lens.SLDPRT

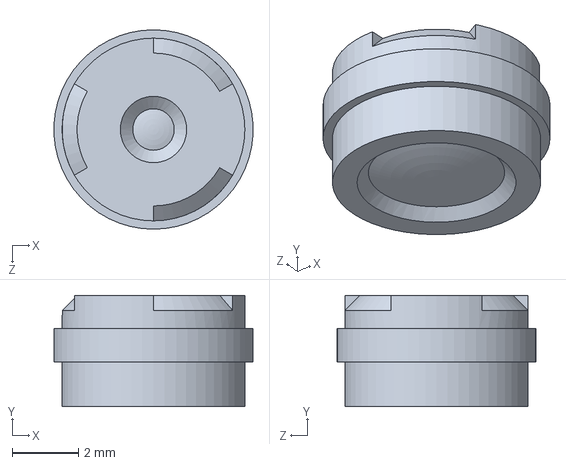
[picture p44: CAD file, 2022-03-22]
Платформа/solid/rpi camera/OVA5647_Lens.SLDPRT
5.99 x 3.35 x 6.00 mm
