HelenTsvetkova/KMM-2021/Схват/Pièce2.SLDPRT

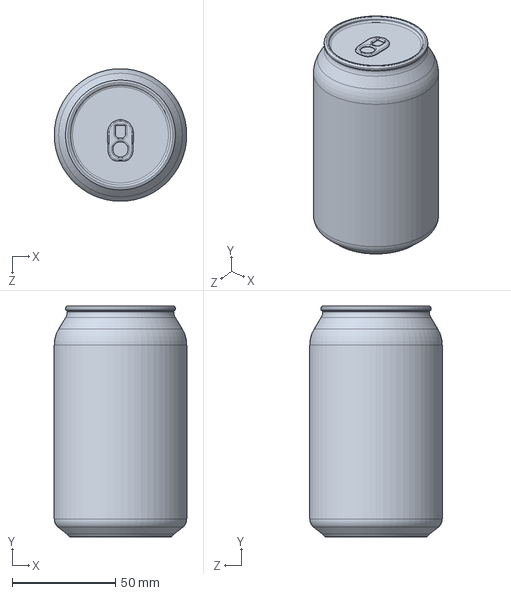
[picture p45: CAD file, 2022-04-01]
Схват/Pièce2.SLDPRT
64.2 x 112.0 x 64.2 mm
