HelenTsvetkova/KMM-2021/Платформа/solid/raspberry pi 4 b/Female USB Type C Connector, RPi4ModelB.SLDPRT

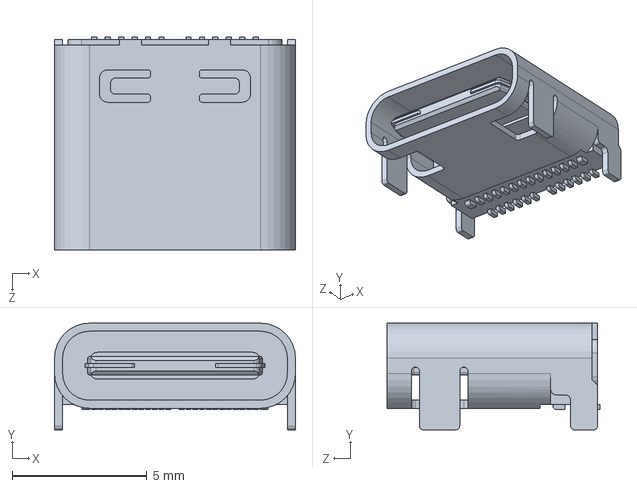
[picture p46: CAD file, 2022-03-22]
Платформа/solid/raspberry pi 4 b/Female USB Type C Connector, RPi4ModelB.SLDPRT
8.94 x 3.96 x 7.90 mm
