HelenTsvetkova/KMM-2021/Схват/Upper.SLDPRT

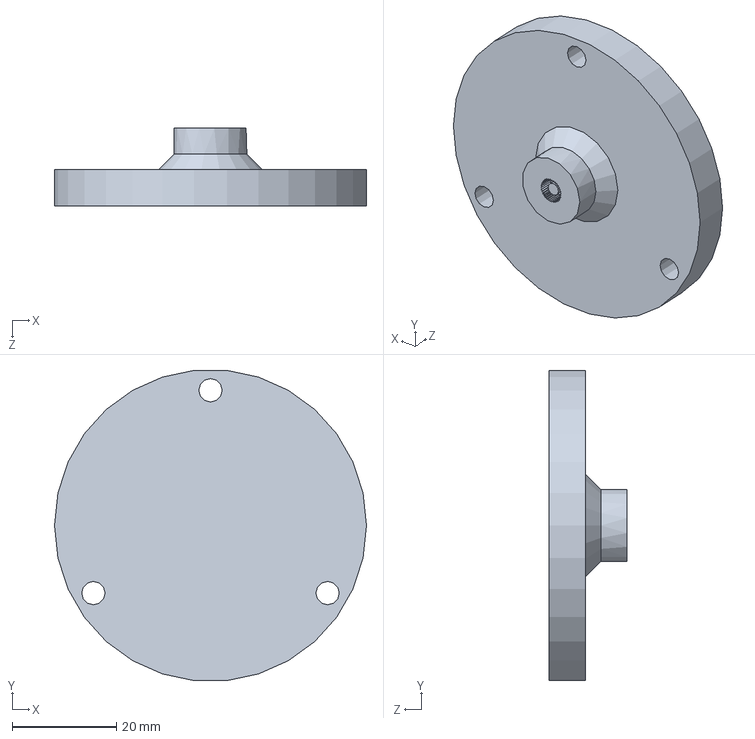
[picture p47: CAD file, 2022-04-01]
Схват/Upper.SLDPRT
60.0 x 59.7 x 15.0 mm
