HelenTsvetkova/KMM-2021/Платформа/solid/raspberry pi 4 b/2X USB2.0 PORTS, RPi4ModelB.SLDPRT

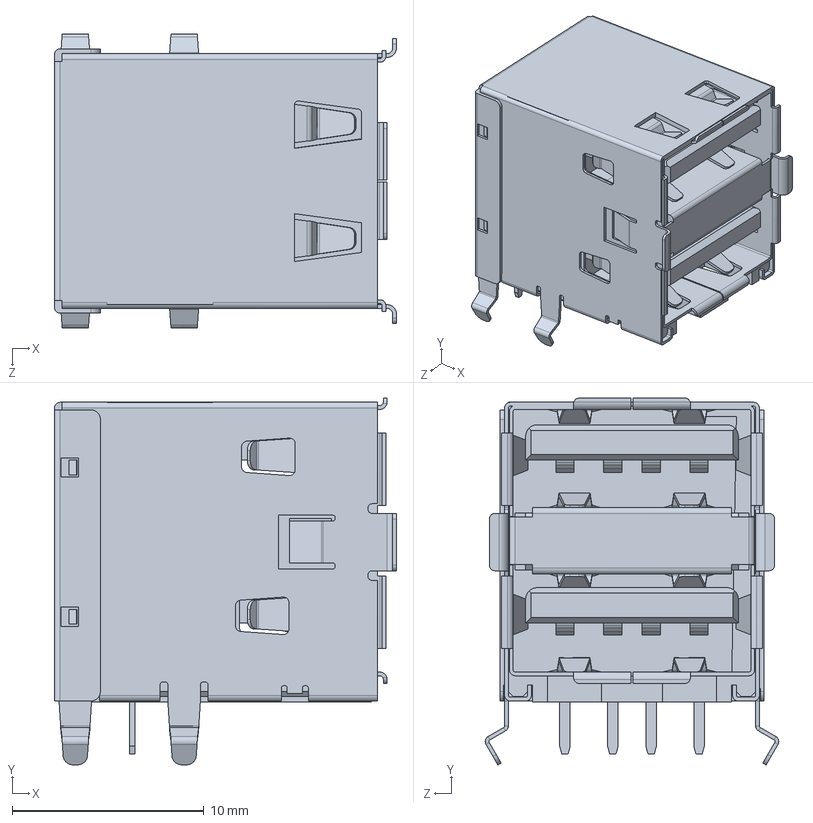
[picture p48: CAD file, 2022-03-22]
Платформа/solid/raspberry pi 4 b/2X USB2.0 PORTS, RPi4ModelB.SLDPRT
17.9 x 19.2 x 15.3 mm
