HelenTsvetkova/KMM-2021/Схват/Shupal'ze22.SLDPRT

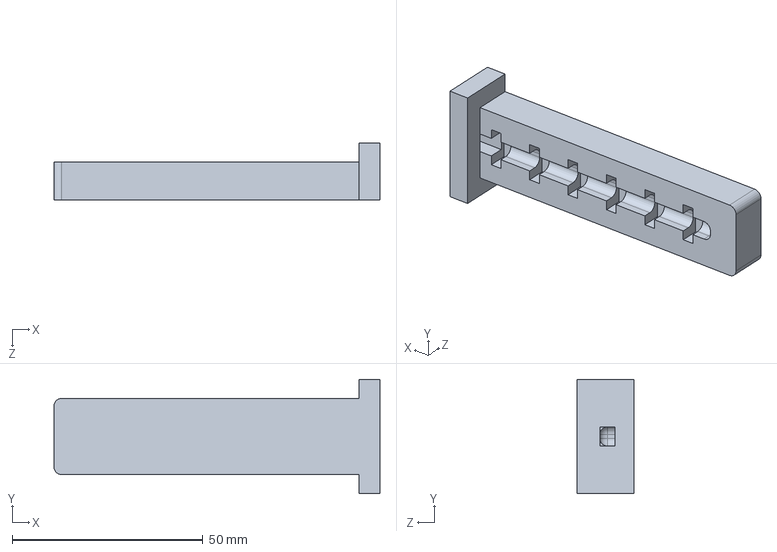
[picture p49: CAD file, 2022-04-01]
Схват/Shupal'ze22.SLDPRT
85.5 x 30.0 x 15.0 mm
