HelenTsvetkova/KMM-2021/Платформа/solid/raspberry pi 4 b/VIA VL805 PCIe USB 3.0 controller, RPi4ModelB.SLDPRT

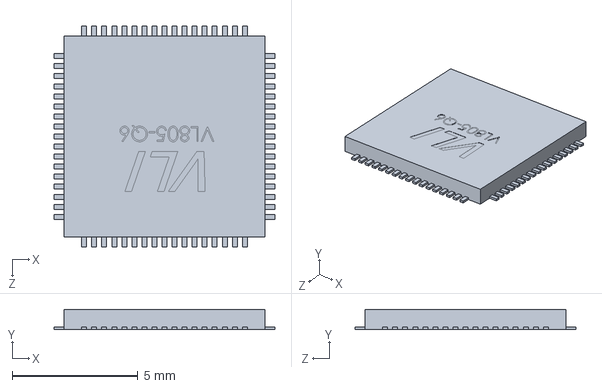
[picture p50: CAD file, 2022-03-22]
Платформа/solid/raspberry pi 4 b/VIA VL805 PCIe USB 3.0 controller, RPi4ModelB.SLDPRT
8.80 x 0.8 x 8.80 mm
