HelenTsvetkova/KMM-2021/Схват/Tkan'.SLDPRT

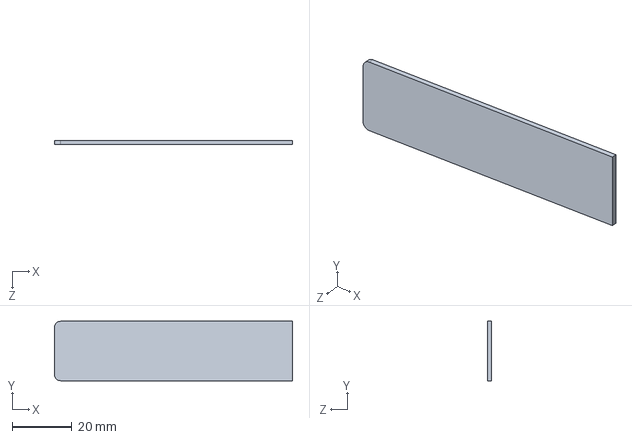
[picture p51: CAD file, 2022-04-01]
Схват/Tkan'.SLDPRT
80.0 x 20.0 x 1.50 mm
