HelenTsvetkova/KMM-2021/Платформа/solid/raspberry pi 4 b/Female Micro HDMI Connector, RPi4ModelB.SLDPRT

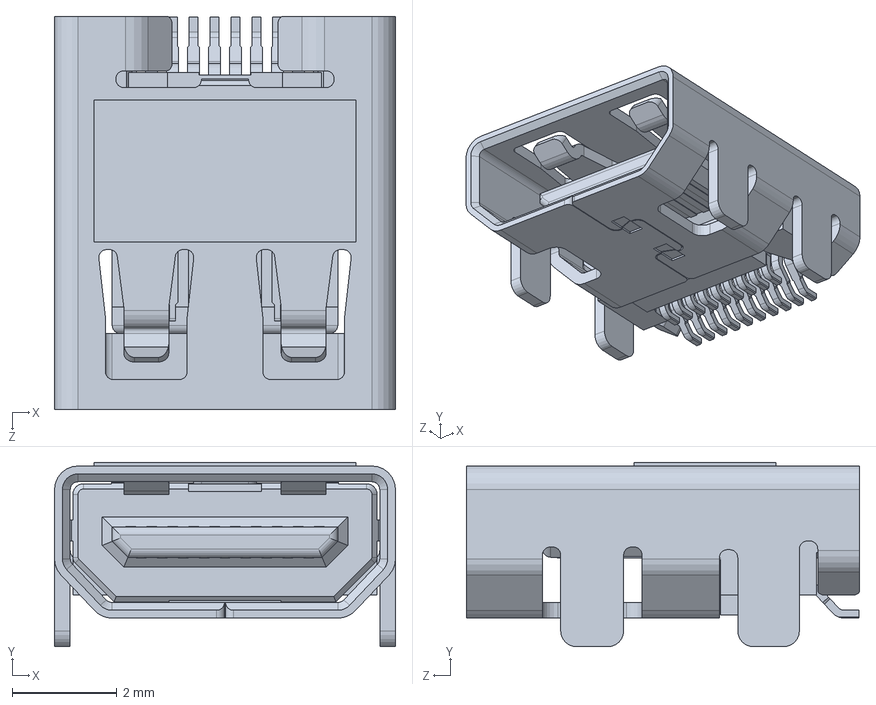
[picture p52: CAD file, 2022-03-22]
Платформа/solid/raspberry pi 4 b/Female Micro HDMI Connector, RPi4ModelB.SLDPRT
6.50 x 3.52 x 7.50 mm
