HelenTsvetkova/KMM-2021/Платформа/solid/raspberry pi 4 b/Microphone Plug, RPi4ModelB.SLDPRT

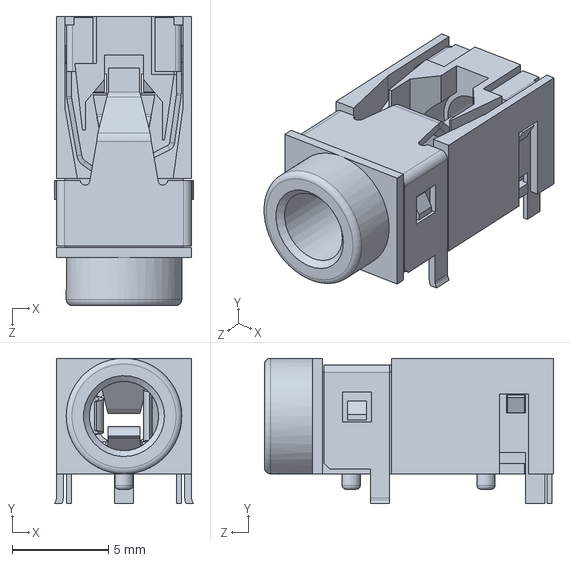
[picture p53: CAD file, 2022-03-22]
Платформа/solid/raspberry pi 4 b/Microphone Plug, RPi4ModelB.SLDPRT
7.23 x 7.55 x 15.0 mm
