HelenTsvetkova/KMM-2021/Схват/Ø4 x M5 COTOVELO 90° MACHO GIRAT. (C02470405).sldprt

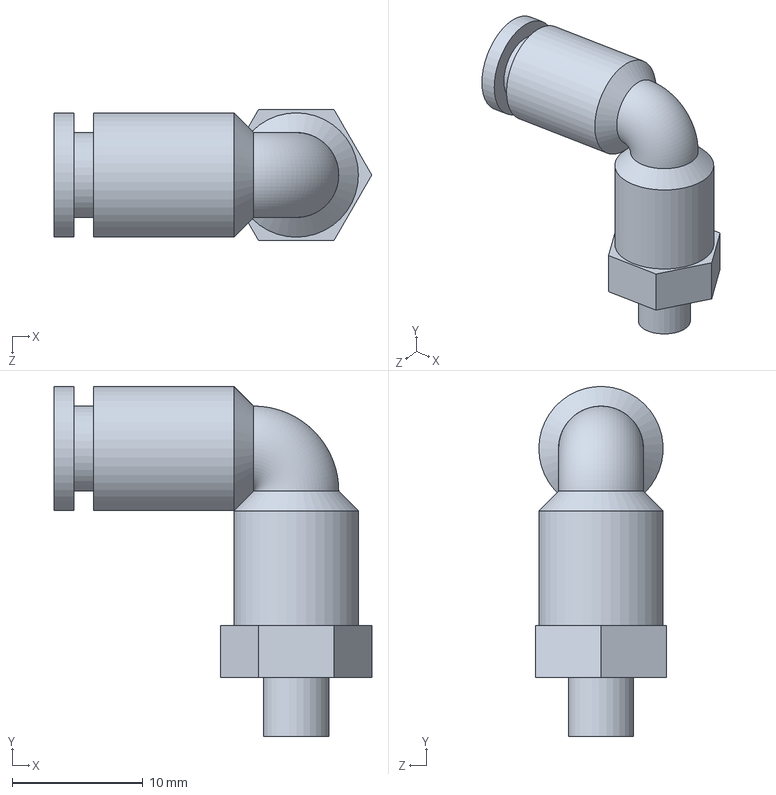
[picture p54: CAD file, 2022-04-01]
Схват/Ø4 x M5 COTOVELO 90° MACHO GIRAT. (C02470405).sldprt
24.3 x 26.7 x 10.0 mm
