HelenTsvetkova/KMM-2021/Схват/Плечо.SLDPRT

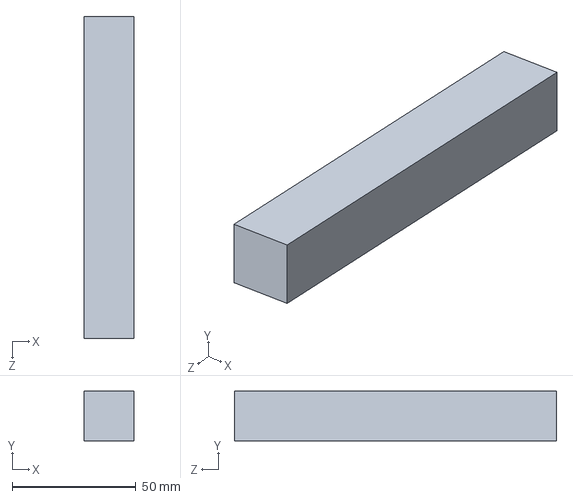
[picture p55: CAD file, 2022-04-01]
Схват/Плечо.SLDPRT
20.0 x 20.0 x 130.0 mm
