HelenTsvetkova/KMM-2021/Платформа/solid/raspberry pi 4 b/Broadcom BCM54213PE Gigabit Ethernet Transceiver, RPi4ModelB.SLDPRT

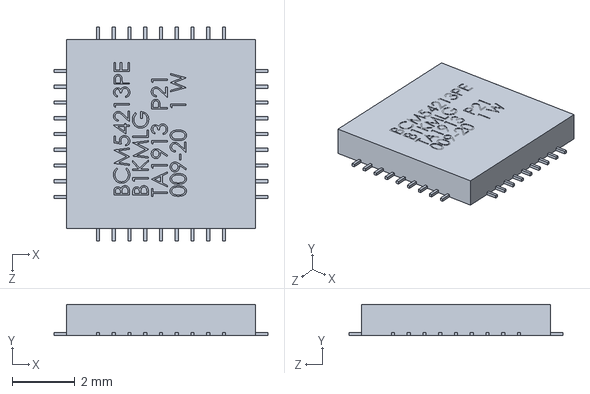
[picture p56: CAD file, 2022-03-22]
Платформа/solid/raspberry pi 4 b/Broadcom BCM54213PE Gigabit Ethernet Transceiver, RPi4ModelB.SLDPRT
6.80 x 1.00 x 6.80 mm
