HelenTsvetkova/KMM-2021/Платформа/solid/raspberry pi 4 b/2X USB3.0 PORTS, RPi4ModelB.SLDPRT

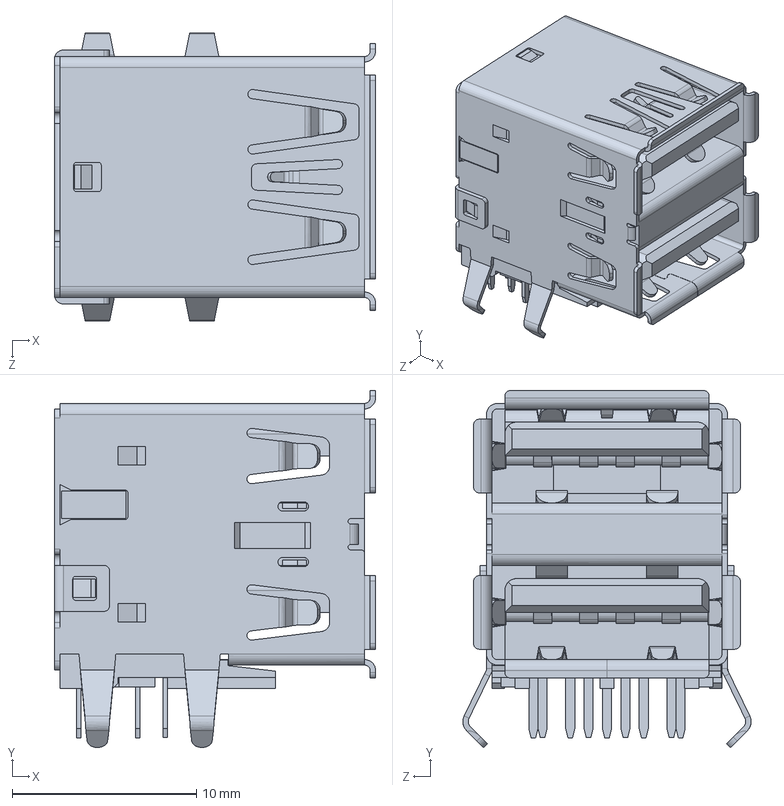
[picture p57: CAD file, 2022-03-22]
Платформа/solid/raspberry pi 4 b/2X USB3.0 PORTS, RPi4ModelB.SLDPRT
17.5 x 19.4 x 15.7 mm
