HelenTsvetkova/KMM-2021/(list of files, cad)

Other CAD files:
Платформа/solid/actuator/STIFTLEISTE_1X1_ASM.sldasm
Платформа/solid/xl4015 dc dc stepdown/Coil v9.sldasm
Платформа/solid/actuator/IC_5X10X2.sldprt
Платформа/solid/STIFTLEISTE_1X1_K.sldprt
Платформа/solid/xl4015 dc dc stepdown/DG301-5.0-02 v1.sldprt
Платформа/solid/actuator/DEC_24-2_MODULE_PCB.sldprt
Платформа/solid/Spira.sldprt
Платформа/solid/actuator/DEC_24-2_MODULE_PCB_SI-T.sldprt
Платформа/solid/Toro.sldprt
Платформа/solid/xl4015 dc dc stepdown/SC-59A v1.sldprt
Платформа/solid/actuator/DROSSEL_3X3X1-5.sldprt
Платформа/solid/STIFTLEISTE_STIFT.sldprt
Платформа/solid/xl4015 dc dc stepdown/SpiraCodA.sldprt
Платформа/solid/actuator/CAP_C3216.sldprt
Платформа/solid/SpiraCpdB.sldprt
Платформа/solid/xl4015 dc dc stepdown/DO-214AB v1.sldprt
Платформа/solid/actuator/CAP_C3225.sldprt
Платформа/solid/SpiraCodA.sldprt
Платформа/solid/xl4015 dc dc stepdown/LED v1.sldprt
Платформа/solid/actuator/IC_SO-08.sldprt
Платформа/solid/xl4015 dc dc stepdown/Trimpot 3296W v1.sldprt
Платформа/solid/actuator/STIFTLEISTE_1X1_K.sldprt
Платформа/solid/xl4015 dc dc stepdown/UPC78L08T-E1-AZ.sldprt
Платформа/solid/xl4015 dc dc stepdown/Spira.sldprt
Платформа/solid/xl4015 dc dc stepdown/XL4015 TO263-5-1 v1.sldprt
Платформа/solid/xl4015 dc dc stepdown/SpiraCpdB.sldprt
Платформа/solid/actuator/DEC_24-2_MODULE_PCB_SI-B.sldprt
Платформа/solid/xl4015 dc dc stepdown/Toro.sldprt
Платформа/solid/actuator/IC_4X4X1.sldprt
Платформа/solid/actuator/STIFTLEISTE_STIFT.sldprt
Платформа/solid/xl4015 dc dc stepdown/Basetta.sldprt
Платформа/solid/xl4015 dc dc stepdown/CAPACITOR 10x10 SMD v1.sldprt
Платформа/solid/xl4015 dc dc stepdown/LM358 SOIC08 v1.sldprt
Платформа/solid/actuator/367661_dec_module_24-2.SLDASM
Платформа/solid/actuator/496650_ec-i40_50w_a.SLDPRT
Платформа/solid/rpi camera/OVA5647.SLDPRT
Схват/DIN_912-M4x30.stp
Схват/M4x3.3mm Hex Nut (FIX-M4).step
