HelenTsvetkova/KMM-2021/(commit log)

2022-03-18 Рассчёты движков
2022-03-18 Добавляю ПЗ платформа
2022-03-22 add solid
    [2.54 mm DUPONT MALE PIN HEADER, IO, 2X20, RPi4ModelB.SLDPRT, 2.54 mm DUPONT MALE PIN HEADER, IO, 2X40, RPi4ModelB.SLDPRT, 2.54 mm DUPONT MALE PIN HEADER, POE, 2X2, RPi4ModelB.SLDPRT, 2X USB2.0 PORTS, RPi4ModelB.SLDPRT, 2X USB3.0 PORTS, RPi4ModelB.SLDPRT, 367661_dec_module_24-2.SLDASM, 496650_ec-i40_50w_a.SLDPRT, 91D77 D9WHV 778K, 4 GB LPDDR4 SDRAM, RPi4ModelB.SLDPRT]
2022-03-22 подгрузил хуеты
2022-04-07 соединила 3 главы в одну ПЗ
2022-04-20 Манипулятор с проводами и обновлёнными деталями
2022-04-27 new wire canal
2022-05-03 ПЗ 2
